notiren/bmw-bluetooth-media-bridge/hardware/enclosure/box.stl

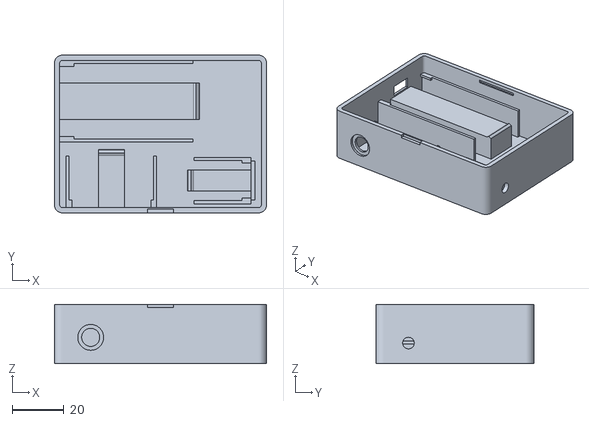
[picture p3: CAD file, 2026-10-20]
hardware/enclosure/box.stl
82.0 x 61.0 x 23.0
