notiren/bmw-bluetooth-media-bridge/hardware/enclosure/lid.stl

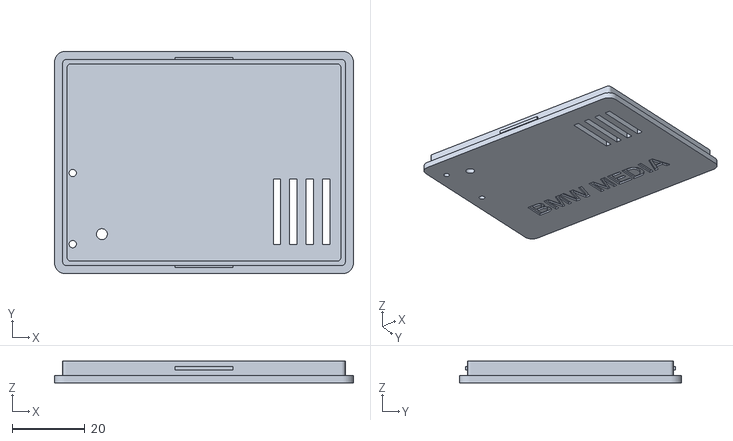
[picture p4: CAD file, 2026-10-20]
hardware/enclosure/lid.stl
82.0 x 61.0 x 6.00
