notiren/bmw-bluetooth-media-bridge/src/app_ble/main.cpp

// ESP32-S3 / ESP32-C3 main firmware.
// Reads BMW steering-wheel buttons (0x1D6, K-CAN, listen-only) and sends them
// to the phone as BLE HID consumer-control keys (Next / Previous / Play-Pause).
// Audio is handled by a separate Bluetooth-to-AUX receiver: the S3/C3 have no
// Bluetooth Classic and therefore cannot receive A2DP audio.
//
// Pair the phone with "BMW E92 Buttons" from the phone's Bluetooth settings.
//
// Voice acts on release: short press = Play/Pause, hold 2 s = Wi-Fi on/off
// (Wi-Fi dashboard + OTA in dashboard.cpp, -DENABLE_DASHBOARD=1).
#include <Arduino.h>
#include <NimBLEDevice.h>
#include <NimBLEHIDDevice.h>
#include "../common/bench_fake_can.h"
#include "../common/can_bus.h"
#include "../common/kcan_dash.h"
#include "../common/mfl.h"
#include "../common/watchdog.h"
#include "../common/dashboard.h"

#ifndef CAN_BITRATE
#define CAN_BITRATE 100000
#endif
#ifndef FW_VERSION
#define FW_VERSION "dev"
#endif
#ifndef BLE_DEVICE_NAME
#define BLE_DEVICE_NAME "BMW E92 Buttons"
#endif

// Consumer-control report: 1 byte, one bit per key.
enum : uint8_t {
    KEY_NEXT = 1 << 0,
    KEY_PREV = 1 << 1,
    KEY_PLAY_PAUSE = 1 << 2,
};

static const uint8_t kReportMap[] = {
    0x05, 0x0C,        // Usage Page (Consumer)
    0x09, 0x01,        // Usage (Consumer Control)
    0xA1, 0x01,        // Collection (Application)
    0x85, 0x01,        //   Report ID (1)
    0x15, 0x00,        //   Logical Minimum (0)
    0x25, 0x01,        //   Logical Maximum (1)
    0x75, 0x01,        //   Report Size (1)
    0x95, 0x03,        //   Report Count (3)
    0x09, 0xB5,        //   Usage (Scan Next Track)
    0x09, 0xB6,        //   Usage (Scan Previous Track)
    0x09, 0xCD,        //   Usage (Play/Pause)
    0x81, 0x02,        //   Input (Data, Var, Abs)
    0x95, 0x05,        //   Report Count (5) padding
    0x81, 0x03,        //   Input (Const)
    0xC0,              // End Collection
};

static constexpr uint32_t kVoiceHoldMs = 2000;

static NimBLECharacteristic *g_input = nullptr;
static volatile bool g_connected = false;
static MflDecoder g_mfl;
static KcanDash g_dash;
static bool g_voicePending = false;
static uint32_t g_voiceDownMs = 0;

// CAN is read in its own task so Bluetooth and Wi-Fi work in loop() cannot
// make the controller's small receive buffer overflow.
static QueueHandle_t g_canQueue = nullptr;

static void canTask(void *) {
    watchdogWatchThisTask();
    CanFrame f;
    for (;;) {
        watchdogFeed();
        if (canRead(f, 5)) xQueueSend(g_canQueue, &f, 0);
    }
}

class ServerCallbacks : public NimBLEServerCallbacks {
    void onConnect(NimBLEServer *) override {
        g_connected = true;
        Serial.println("BLE: phone connected");
    }
    void onDisconnect(NimBLEServer *) override {
        g_connected = false;
        Serial.println("BLE: disconnected, advertising again");
        NimBLEDevice::startAdvertising();
    }
};

static void bleBegin() {
    NimBLEDevice::init(BLE_DEVICE_NAME);
    NimBLEDevice::setSecurityAuth(true, false, true);  // bonding, no MITM, secure connections
    NimBLEDevice::setSecurityIOCap(BLE_HS_IO_NO_INPUT_OUTPUT);

    NimBLEServer *server = NimBLEDevice::createServer();
    server->setCallbacks(new ServerCallbacks());

    NimBLEHIDDevice *hid = new NimBLEHIDDevice(server);
    g_input = hid->inputReport(1);
    hid->manufacturer()->setValue("DIY");
    hid->pnp(0x02, 0xE502, 0xA111, 0x0210);
    hid->hidInfo(0x00, 0x01);
    hid->reportMap((uint8_t *)kReportMap, sizeof(kReportMap));
    hid->setBatteryLevel(100);
    hid->startServices();

    NimBLEAdvertising *adv = NimBLEDevice::getAdvertising();
    adv->setAppearance(0x03C0);  // generic HID (not "keyboard": keeps iOS on-screen keyboard)
    adv->addServiceUUID(hid->hidService()->getUUID());
    adv->setScanResponse(true);
    adv->start();
    Serial.printf("BLE: advertising as \"%s\"\n", BLE_DEVICE_NAME);
}

static void sendKey(uint8_t key) {
    if (!g_connected || !g_input) return;
    uint8_t report = key;
    g_input->setValue(&report, 1);
    g_input->notify();
    delay(30);
    report = 0;
    g_input->setValue(&report, 1);
    g_input->notify();
}

static void runAction(MflButton b) {
    uint8_t key = 0;
    switch (b) {
        case MFL_NEXT: key = KEY_NEXT; break;
        case MFL_PREV: key = KEY_PREV; break;
        case MFL_VOICE:
        case MFL_PHONE: key = KEY_PLAY_PAUSE; break;
        default: return;  // volume stays with the factory radio
    }
    Serial.printf("MFL %s -> BLE key 0x%02X%s\n", mflButtonName(b), key,
                  g_connected ? "" : " (no phone connected)");
    dashboardNoteButton(mflButtonName(b));
    sendKey(key);
}

static void handlePress(MflButton b, uint32_t now) {
    if (b == MFL_VOICE) {  // decided on release or after the hold time
        g_voicePending = true;
        g_voiceDownMs = now;
        return;
    }
    runAction(b);
}

static void voiceHoldCheck(uint32_t now) {
    if (!g_voicePending) return;
    const bool held = g_mfl.heldMask() & (1 << MFL_VOICE);
    if (held && now - g_voiceDownMs >= kVoiceHoldMs) {
        g_voicePending = false;
        dashboardToggleWifi();
        dashboardNoteButton(dashboardWifiOn() ? "WIFI ON" : "WIFI OFF");
    } else if (!held) {
        g_voicePending = false;
        runAction(MFL_VOICE);
    }
}

// Bench test over the serial monitor: n/p/t = Next/Previous/Play-Pause,
// w = Wi-Fi on/off.
static void benchCommands() {
    if (!Serial.available()) return;
    switch (Serial.read()) {
        case 'n': runAction(MFL_NEXT); break;
        case 'p': runAction(MFL_PREV); break;
        case 't': runAction(MFL_PHONE); break;
        case 'w': dashboardToggleWifi(); break;
        default: break;
    }
}

void setup() {
    // 80 MHz is plenty for CAN + BLE (+ Wi-Fi) and runs cooler than 160 MHz.
    setCpuFrequencyMhz(80);
    Serial.begin(115200);
    delay(500);
    Serial.println("Firmware v" FW_VERSION);
    Serial.printf("Reset: %s\n", resetReasonName());
    watchdogBegin();
    bleBegin();
    g_canQueue = xQueueCreate(64, sizeof(CanFrame));
#if BENCH_FAKE_CAN
    Serial.println("CAN: fake frames (BENCH_FAKE_CAN)");
    xTaskCreate(benchFakeCanTask, "fakecan", 4096, g_canQueue, 2, nullptr);
#else
    if (canBegin(CAN_BITRATE)) {
        Serial.printf("CAN: %s @ %lu bit/s listen-only\n", canBackendName(),
                      (unsigned long)CAN_BITRATE);
        xTaskCreate(canTask, "can", 4096, nullptr, 2, nullptr);
    } else {
        Serial.println("!! CAN init failed");
    }
#endif
    dashboardBegin(g_dash, g_connected);
}

void loop() {
    watchdogFeed();
    CanFrame f;
    // Wait briefly for the first frame, then drain what is queued (bounded so
    // Wi-Fi/web work still runs on a busy bus).
    TickType_t wait = pdMS_TO_TICKS(10);
    for (int n = 0; n < 64 && xQueueReceive(g_canQueue, &f, wait) == pdTRUE; ++n) {
        wait = 0;
        const uint32_t now = millis();
        const uint8_t pressed = g_mfl.update(f, now);
        for (uint8_t i = 0; i < MFL_BUTTON_COUNT; ++i) {
            if (pressed & (1 << i)) handlePress((MflButton)i, now);
        }
        g_dash.update(f, now);
        dashboardNoteFrame(f, now);
    }
    const uint32_t now = millis();
    g_mfl.tick(now);
    voiceHoldCheck(now);
    benchCommands();
    dashboardLoop();
}
