notiren/bmw-bluetooth-media-bridge/(commit log)

2026-10-10 C3 MCP2515: move CS to GPIO4 and SCK to GPIO7
    Pins now GPIO4-7 = CS, SO, SI, SCK. Verified on ESP32-C3-DevKitM-1:
    MCP2515 init succeeds (8 MHz crystal, listen-only, 100 kbit/s).
2026-10-11 Wi-Fi dashboard + OTA updates, Voice-hold Wi-Fi toggle
    - Wi-Fi dashboard in its own files (ENABLE_DASHBOARD=1 in
    app_ble_esp32c3_mcp2515): speed, RPM, coolant, outside temp,
    battery, fuel, range, last button. Decodings not yet verified on
    the car; "raw" view shows frame bytes.
    - C3 opens its own network "BMW E92 Dash" without a DHCP gateway,
    so the phone keeps mobile data. Off at boot; hold Voice 2 s to
    toggle; auto-off after 10 min unused.
    - Voice: short press = Play/Pause on release, hold = Wi-Fi toggle.
    - OTA: update button / /update page (basic auth) and
    app_ble_esp32c3_mcp2515_ota env (espota).
    - CAN reading moved to a FreeRTOS task + queue.
    - Serial bench commands: n/p/t me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
2026-10-11 CAN sniffer, MCP2515 INT, power savings
    - CAN sniffer page (/can): every K-CAN ID live, changed bytes
    highlighted, Hz, filter, pause, reset.
    - MCP2515 INT on GPIO10 (2.2k/3.3k divider, same as SO):
    frame-driven reads, 10 ms poll fallback; INT diagnostics on the
    sniffer page.
    - CPU at 80 MHz and lower Wi-Fi TX power to run cooler.
    - BENCH_FAKE_CAN flag for testing the dashboard without a car.
    - FW_VERSION 1.4.
    - README: macOS build setup; Next steps split into Installation
    and Roadmap.
2026-10-11 README: supported cars, current version and changelog
2026-10-18 Make classic ESP32 + SN65HVD230 + PCM5102 the main setup (v1.6)
2026-10-20 Add 3D-printable enclosure and update concept image to BMW MEDIA
    OpenSCAD source with box/lid STLs and preview (82 x 61 x 25 mm, rails, snap-fit lid).
2026-10-20 Remove dead MCP2515 code; show TWAI bus status in sniffer
    Replaces the MCP2515 INT badge with running state, bus errors and missed frames.
